shebuildsrobots/graduation_hat_gears/README.md

# Moving gears graduation hat
Print files for a gear-topped graduation hat powered by a 30RPM DC motor. See it in action on [YouTube](https://www.youtube.com/shorts/SgNcz4Yz9Ko).

gear graduation hat

Read everything first! You may need to make modifications depending on what parts are available to you.

## Bill Of Materials

| Component | Quantity | Link |
|---|---|---|
| N20 DC Motor, 30 RPM; ideally side-mounted shaft | 1 | [Amazon](https://www.amazon.com/Hilitand-Brush-Geared-1218GE%E2%80%91N20-Reduction/dp/B08LL9Q7M4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) |
| Coin Cell Battery Holder with on/off switch | 1 |  [DigiKey](https://www.digikey.com/en/products/detail/sparkfun-electronics/13883/6557334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) |
| Graduation hat | 1  | |
| M7 0.3mm thickness shims | 12 | 

#### Notes about materials
The gears generate just enough friction to occasionally lock the motor. It's strongly recommended to include 0.3mm shims under each gear. Note that standard washers (~1.3mm) are too thick. If you only have standard washers, you'll need to vertically scale the base so that the snap-fit gear shafts are taller. 

## Files to print

| Component | Quantity |
|---|---|
| [graduation hat gear mount](https://github.com/shebuildsrobots/graduation_hat_gears/blob/main/graduation%20hat%20gear%20mount.stl) | 1 |
| [gear 1](https://github.com/shebuildsrobots/graduation_hat_gears/blob/main/gear%201.stl) | 1 |
| [gear 2](https://github.com/shebuildsrobots/graduation_hat_gears/blob/main/gear%202.stl) | 2  |
|[gear 3](https://github.com/shebuildsrobots/graduation_hat_gears/blob/main/gear%203.stl) |2 |
|[gear 4](https://github.com/shebuildsrobots/graduation_hat_gears/blob/main/gear%204.stl) |2 |
|[gear 5](https://github.com/shebuildsrobots/graduation_hat_gears/blob/main/gear%205.stl) |2 |
|[gear 6](https://github.com/shebuildsrobots/graduation_hat_gears/blob/main/gear%206.stl) |1 |
|[gear 6 with shaft](https://github.com/shebuildsrobots/graduation_hat_gears/blob/main/gear%206%20with%20shaft.stl) |1 |
|[gear 7](https://github.com/shebuildsrobots/graduation_hat_gears/blob/main/gear%207.stl) |1 |
| optional: [block I gear base](https://github.com/shebuildsrobots/graduation_hat_gears/blob/main/block%20I%20gear%20base.stl) multi color print with [block I gold topper](https://github.com/shebuildsrobots/graduation_hat_gears/blob/main/block%20I%20gold%20topper.stl) sliced on top | 1 |

My original STEP file, should you want to make edits: `gears.step`

## Assembly guide

Add the shims to the base before snapping on the gears.

Punch a hole in the graduation hat where the motor (on the underside of the hat) will connect to gear 5 (on top of the hat).

guide

Solder wires to the gearbox, if necessary, and solder the wires to your coin cell battery holder. Secure this unit with tape (or 3D print a mount) underneath the hat, with the shaft poking through the hole in your graduation hat.

Glue the motor mount base to your graduation hat, with the hole in the base mount centered over the hole in your hat.

Glue `gear 6 with shaft.stl` onto the shaft of your motor after the rest of the gear base and gears are assembled on top.

## Notes and Areas for Improvement
I left a hole in the center of the mount for your tassel, but there's really no place for the tassel to go where it won't disrupt the gears! If you redesign this to accomodate a tassel, you could put all of the mounts on stilts that attach to the hat so that all the gears are slightly raised and the tassel can go underneath.

To make your gear surfaces look nicer, turn on top layer ironing in your advanced slicer settings.
