shebuildsrobots/graduation_hat_gears/gear 7.stl

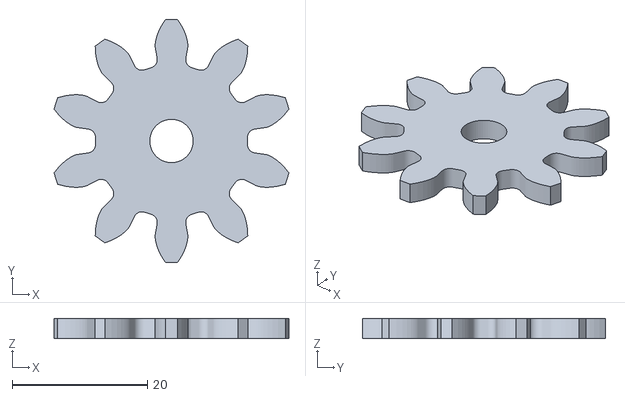
[picture p1: CAD file, 2026-04-06]
gear 7.stl
34.7 x 36.0 x 3.00
