shebuildsrobots/graduation_hat_gears/gear 6.stl

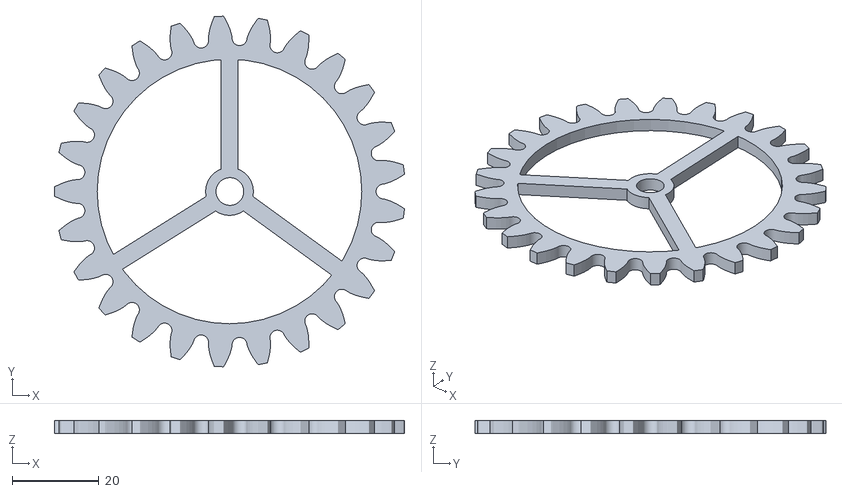
[picture p2: CAD file, 2026-04-06]
gear 6.stl
80.8 x 80.9 x 3.00
