shebuildsrobots/graduation_hat_gears/block I gold topper.stl

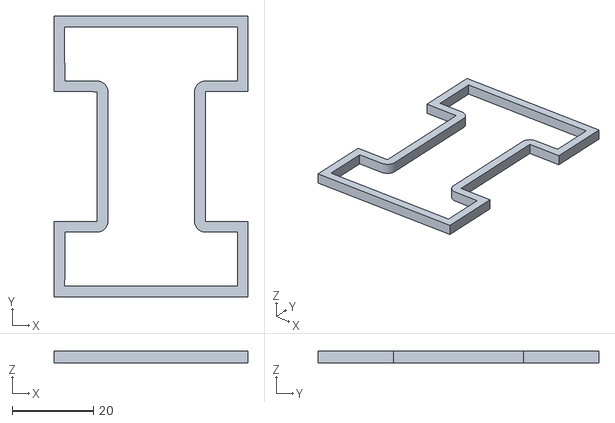
[picture p3: CAD file, 2026-04-06]
block I gold topper.stl
47.7 x 69.0 x 3.00
