shebuildsrobots/graduation_hat_gears/gears.step

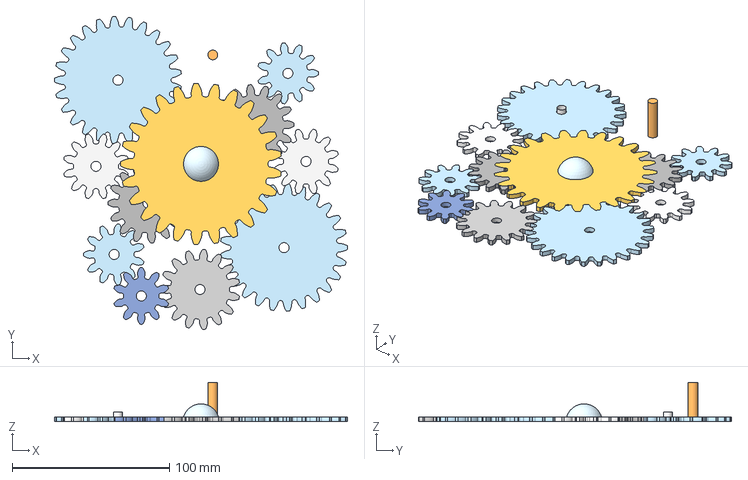
[picture p4: CAD file, 2026-04-06]
gears.step
186.6 x 199.0 x 25.0 mm
