shebuildsrobots/graduation_hat_gears/gear 4.stl

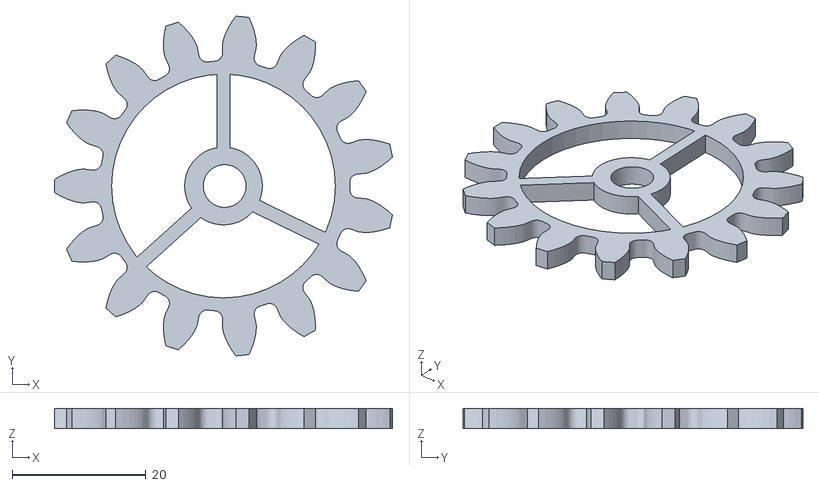
[picture p5: CAD file, 2026-04-06]
gear 4.stl
50.6 x 50.9 x 3.00
