shebuildsrobots/graduation_hat_gears/gear 6 with shaft.stl

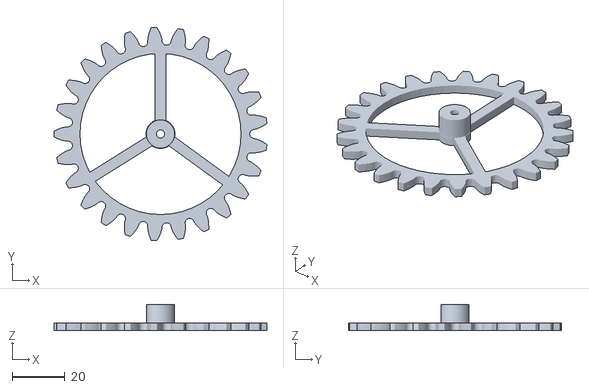
[picture p6: CAD file, 2026-04-06]
gear 6 with shaft.stl
80.8 x 80.9 x 10.0
