shebuildsrobots/graduation_hat_gears/gear 1.stl

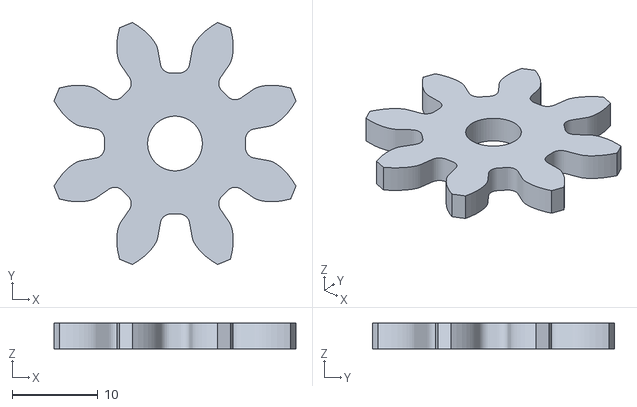
[picture p7: CAD file, 2026-04-06]
gear 1.stl
28.3 x 28.3 x 3.00
