shebuildsrobots/graduation_hat_gears/gear 5.stl

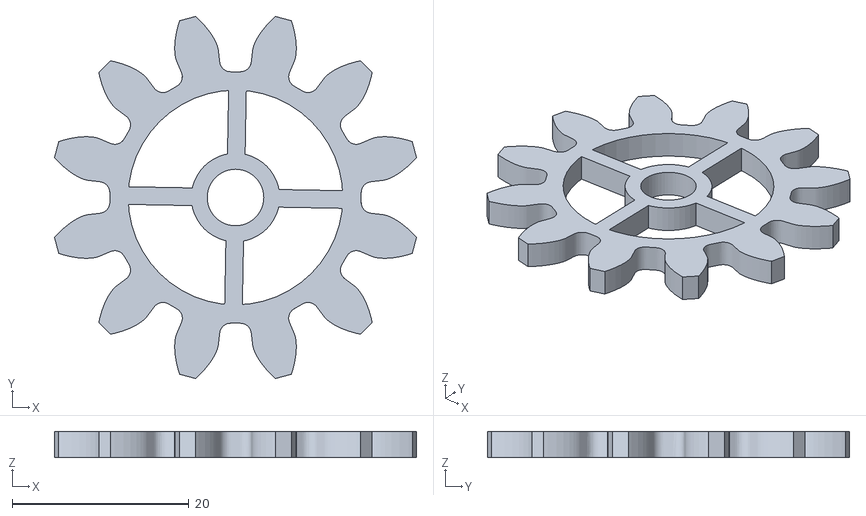
[picture p8: CAD file, 2026-04-06]
gear 5.stl
41.0 x 41.0 x 3.00
