shebuildsrobots/graduation_hat_gears/gear 3.stl

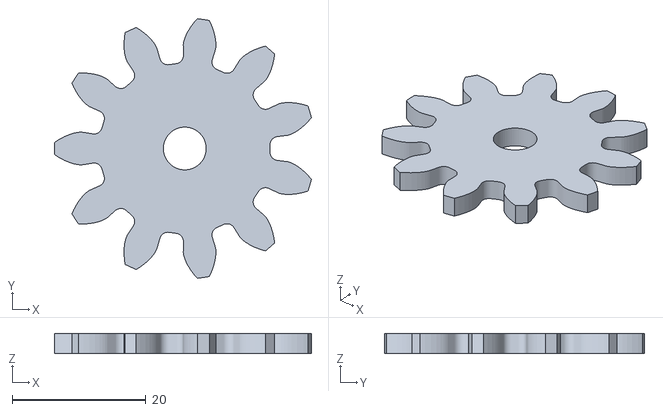
[picture p9: CAD file, 2026-04-06]
gear 3.stl
38.4 x 38.8 x 3.00
