shebuildsrobots/graduation_hat_gears/graduation hat gear mount.stl

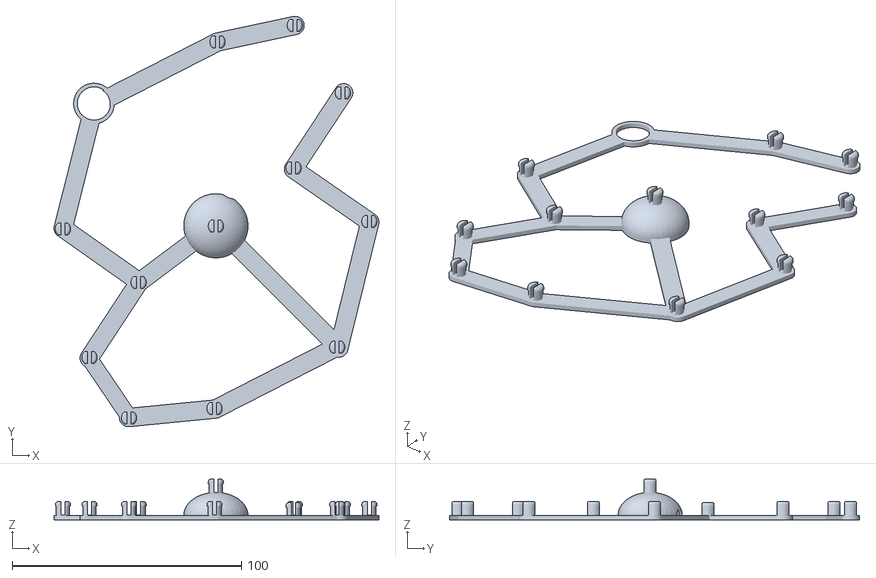
[picture p10: CAD file, 2026-04-06]
graduation hat gear mount.stl
141.7 x 178.9 x 17.8
