shebuildsrobots/graduation_hat_gears/block I gear base.stl

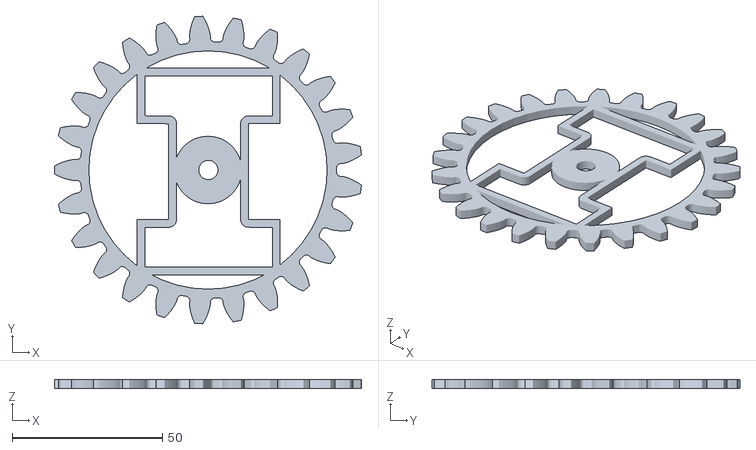
[picture p11: CAD file, 2026-04-06]
block I gear base.stl
102.3 x 102.5 x 3.00
