shebuildsrobots/graduation_hat_gears/gear 2.stl

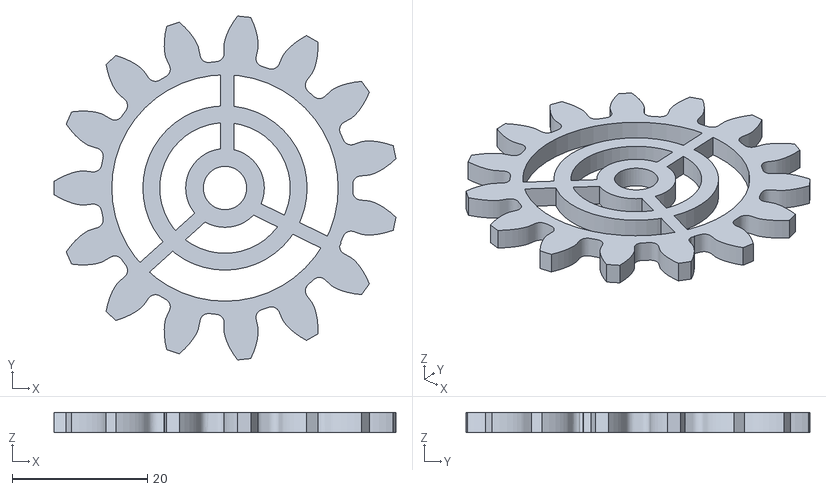
[picture p12: CAD file, 2026-04-06]
gear 2.stl
50.6 x 50.9 x 3.00
