shebuildsrobots/graduation_hat_gears/(commit log)

2026-04-06 Assembly guide
2026-04-06 STL links
